learnindya/Bionic-Clicker/WhatsApp Image 2019-11-04 at 14.49.18.jpeg

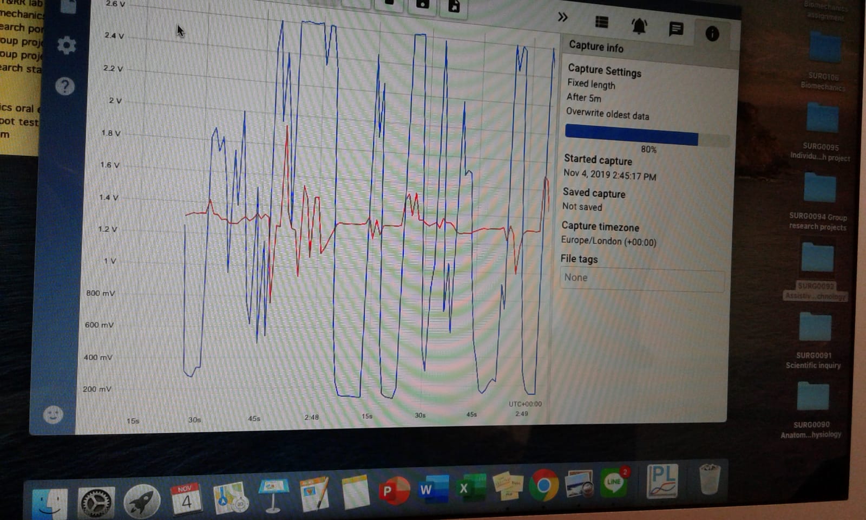
WhatsApp Image 2019-11-04 at 14.49.18.jpeg
