learnindya/Bionic-Clicker/README.md

# Bionic-Clicker
Adaptive Switch Prototype Using Electromyography (EMG) Signal To Access Keyboard Functions
