learnindya/Bionic-Clicker/Bionic clicker raw.png

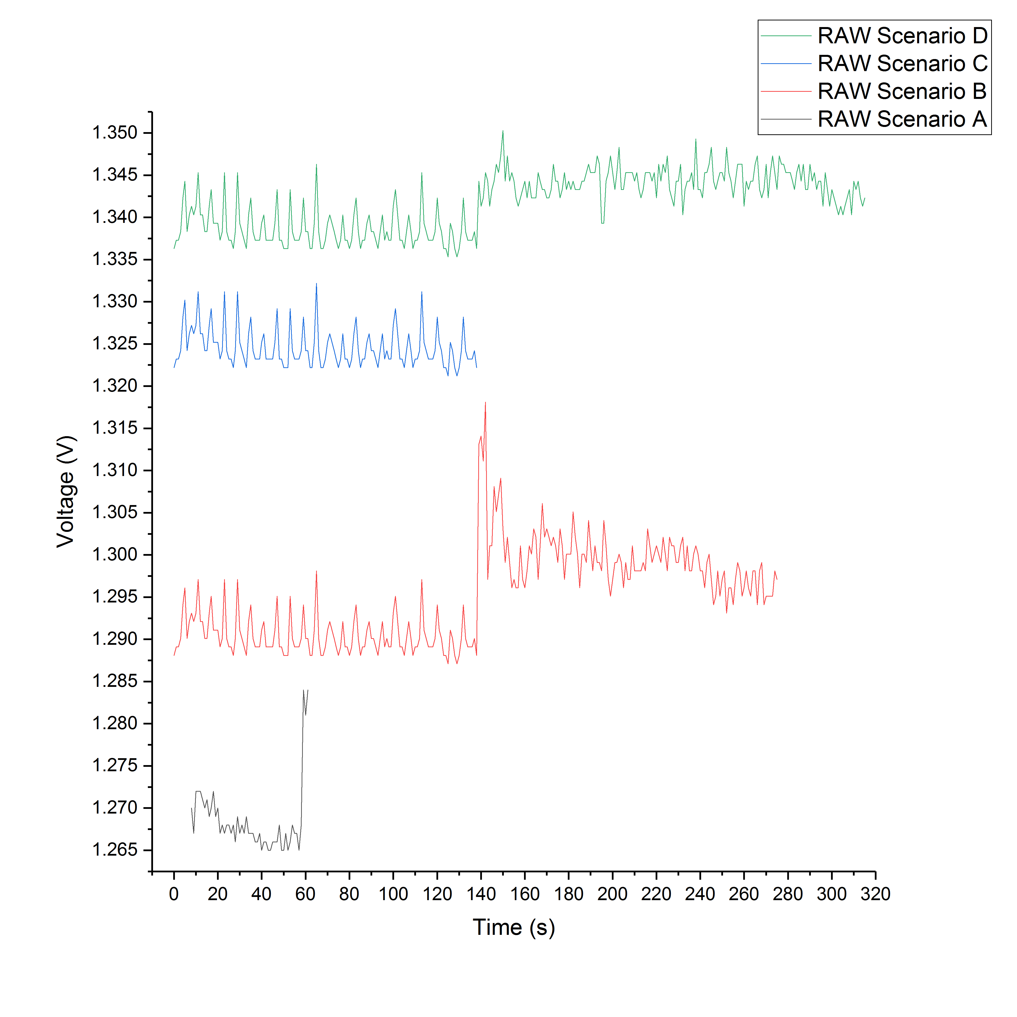
Bionic clicker raw.png
