learnindya/Bionic-Clicker/EMG output 2.jpg

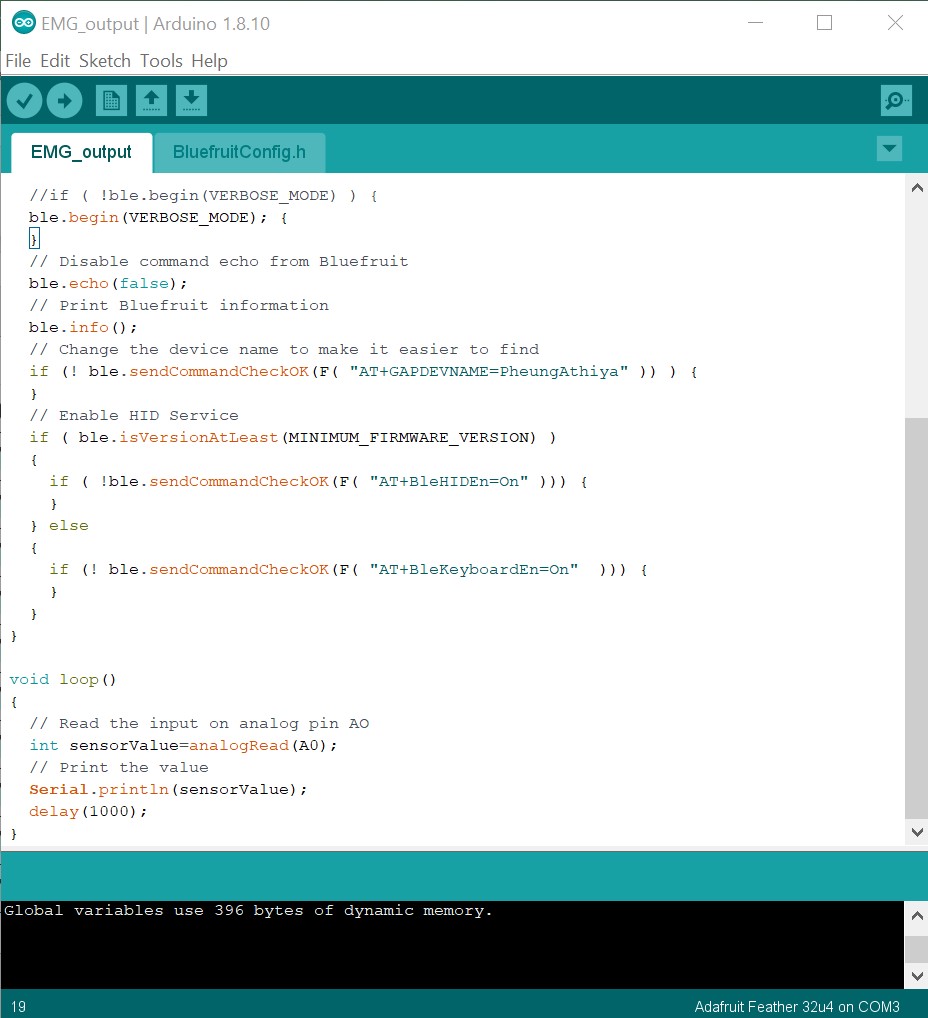
EMG output 2.jpg
