learnindya/Bionic-Clicker/EMG output.jpg

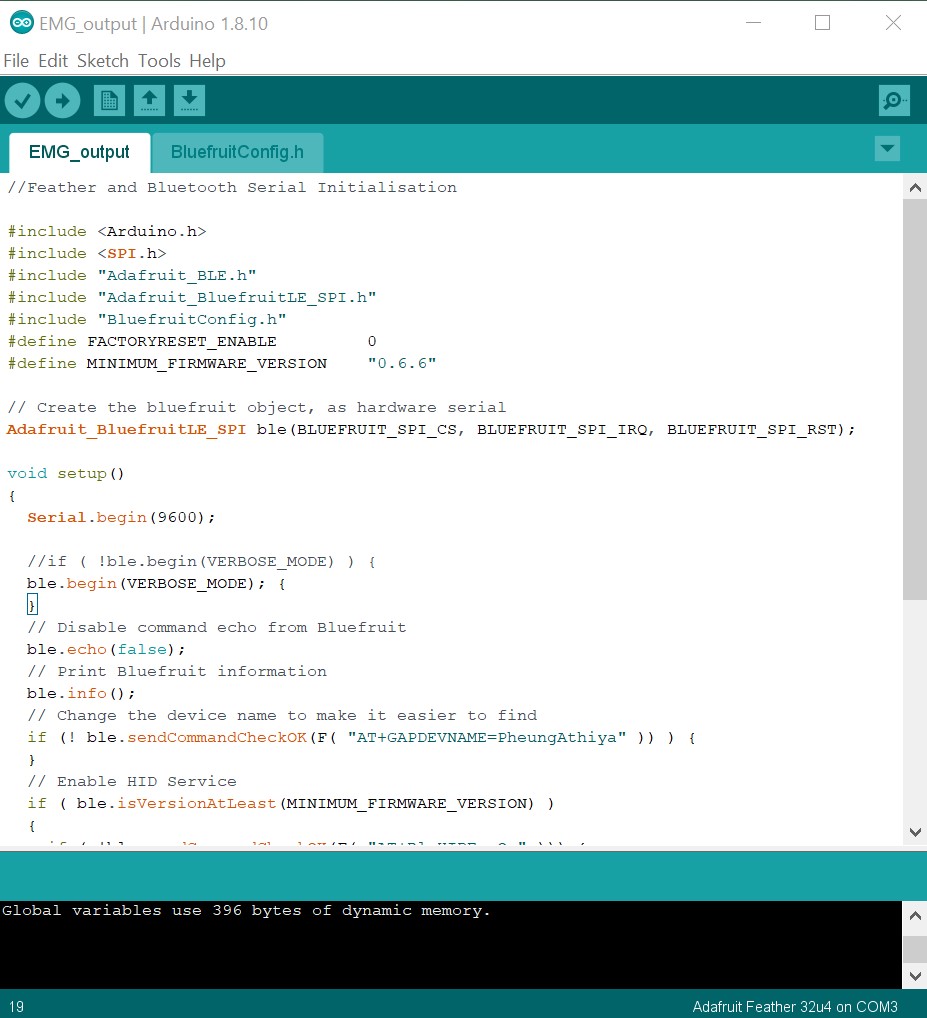
EMG output.jpg
