learnindya/Bionic-Clicker/MyoWare Data Sheet Electrical Specification.jpg

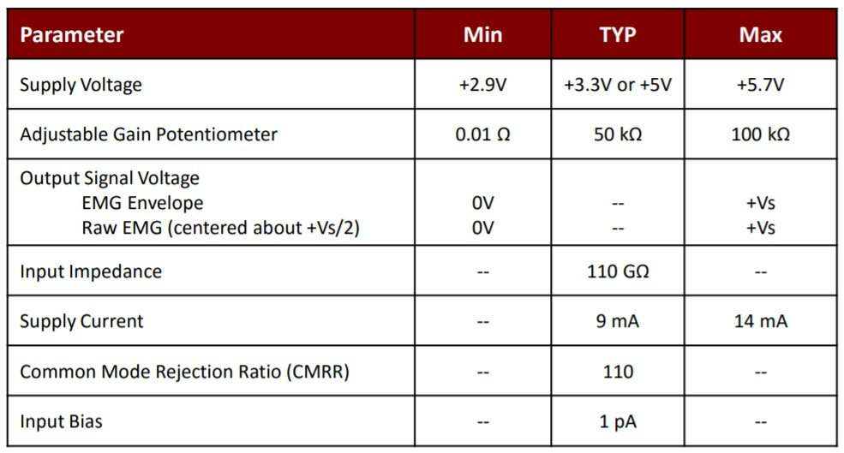
MyoWare Data Sheet Electrical Specification.jpg
