learnindya/Bionic-Clicker/outside forearm.png

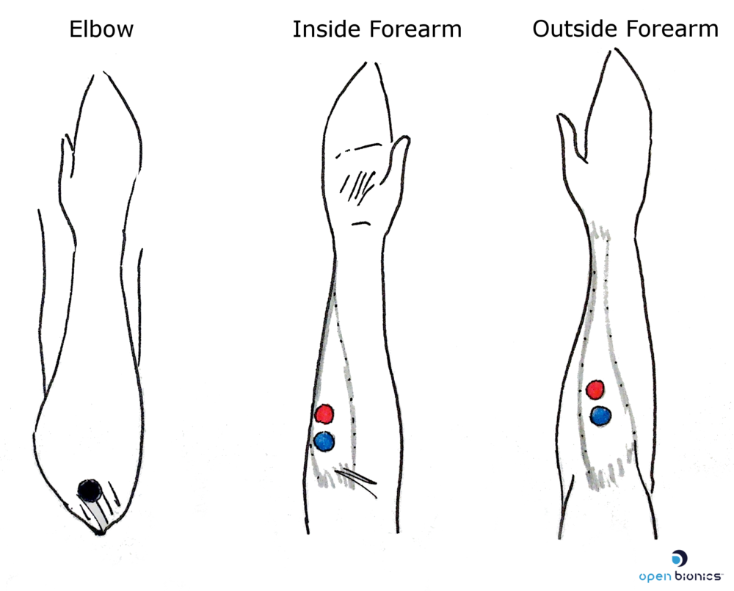
outside forearm.png
