learnindya/Bionic-Clicker/Serial Initialisation 2.jpg

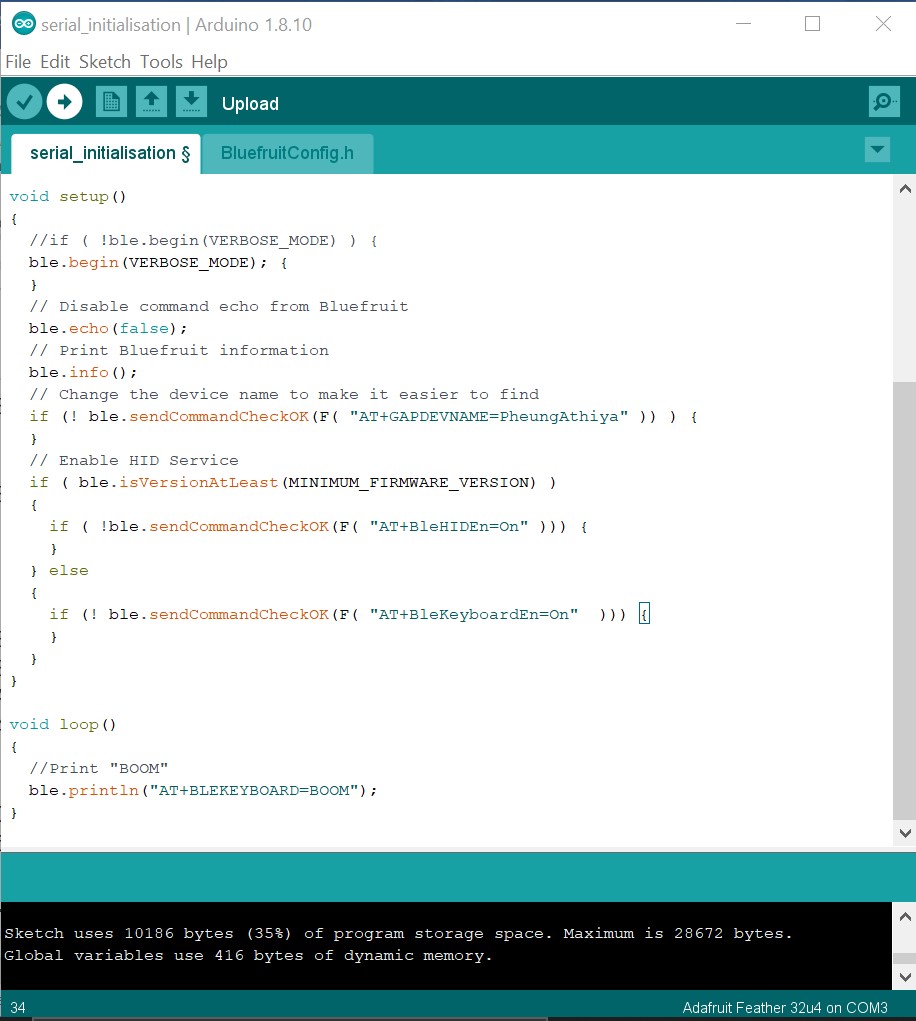
Serial Initialisation 2.jpg
