learnindya/Bionic-Clicker/Serial Initialisation.jpg

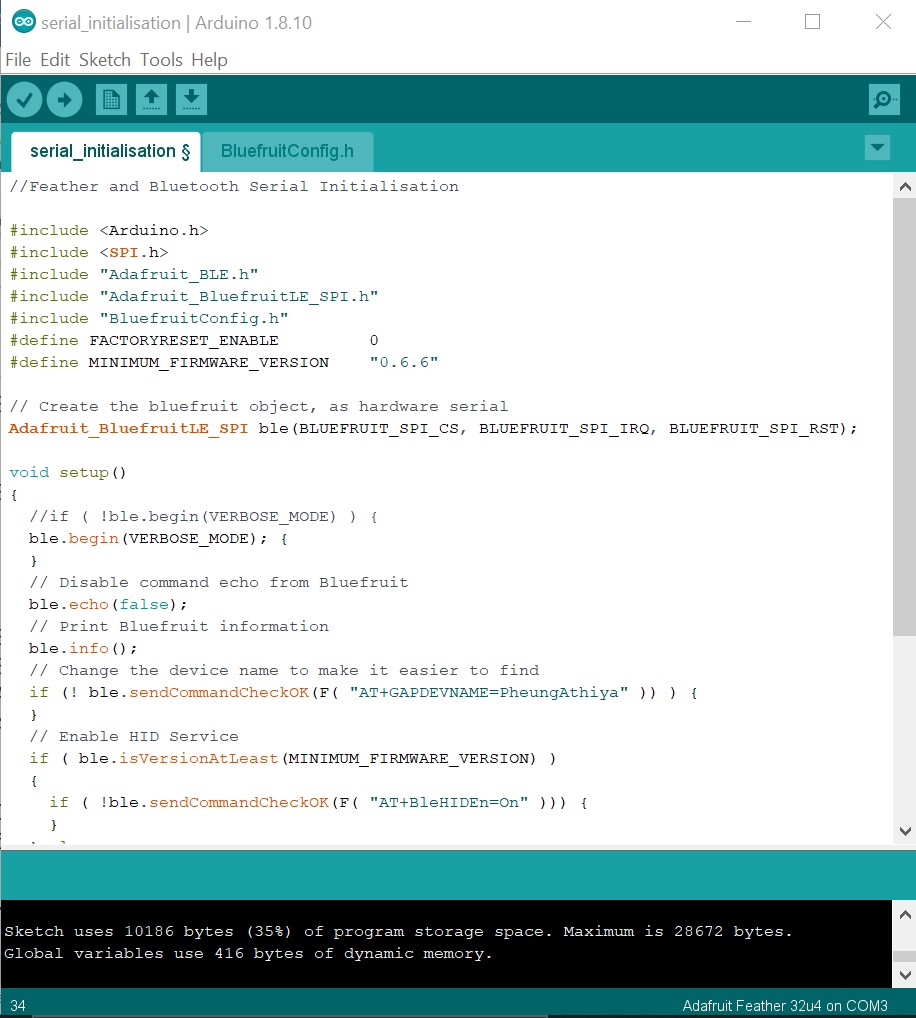
Serial Initialisation.jpg
