learnindya/Bionic-Clicker/WhatsApp Image 2019-11-17 at 11.56.23 (2).jpeg

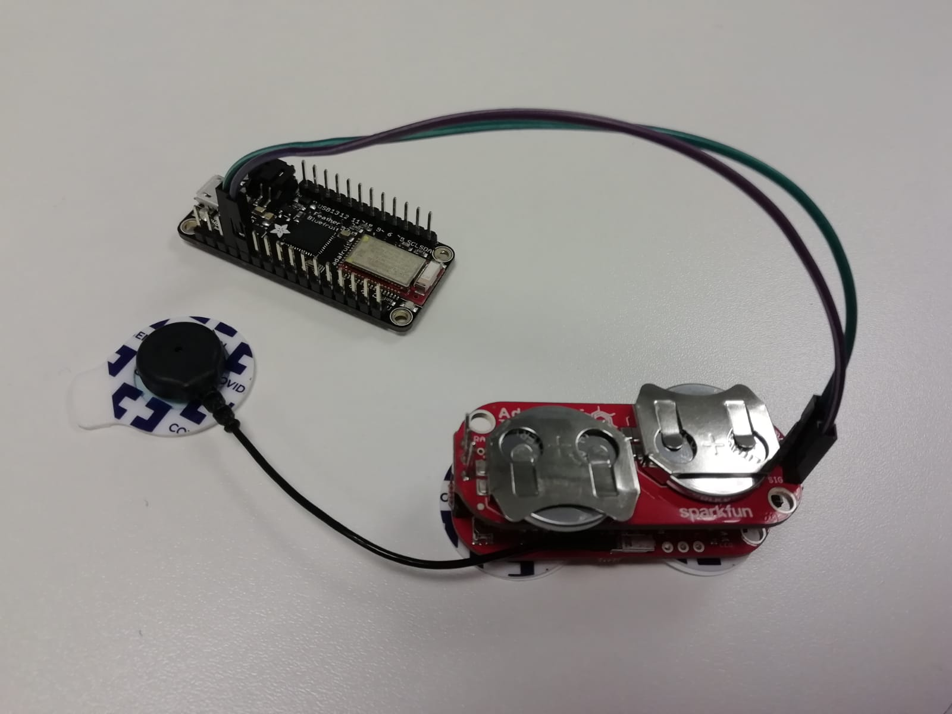
WhatsApp Image 2019-11-17 at 11.56.23 (2).jpeg
