learnindya/Bionic-Clicker/WhatsApp Image 2019-11-17 at 12.03.00.jpeg

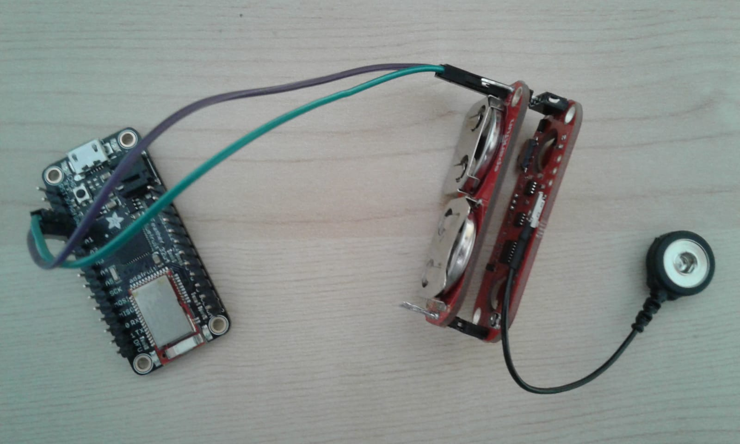
WhatsApp Image 2019-11-17 at 12.03.00.jpeg
