learnindya/Bionic-Clicker/Combined Graph.xlsx

Sheet: A 1-1
 |  |  |  |  | RAW |  |  |  |  |  |  |  |  |  | SIG
 |  | Channel A Last (V) | Channel B Max. (V) |  | rest | rest (avg) |  |  | STD | contract | contract (avg) |  |  | STD | rest | rest (avg) |  |  | STD | contract | contract (avg) |  |  | STD | RAW
 |  |  |  |  |  | 1.268153846 | 1.615135974 | 0.6873045357 | 0.8290383198 |  | 1.268821429 | #REF! | #REF! | #REF! |  | 0.6280769231 | 0.34257609 | 0.2043688857 | 0.4520717706 |  | 1.009892857 | 0.8238866131 | 0.3797114541 | 0.6162073142 | Scenario | Value at Rest (mV) | Value at Contraction (mV)
 |  |  |  |  |  |  | 1.615135974 |  |  |  |  | #REF! |  |  |  |  | 0.34257609 |  |  |  |  | 0.8238866131 |  |  | A
 |  |  |  |  |  |  | 1.615135974 |  |  |  |  | #REF! |  |  |  |  | 0.34257609 |  |  |  |  | 0.8238866131 |  |  | B
 |  |  |  |  |  |  | 1.615135974 |  |  |  |  | #REF! |  |  |  |  | 0.34257609 |  |  |  |  | 0.8238866131 |  |  | C
0:00:08 | 8 | 0.657 | 1.27 | rest | 1.27 |  | 7.744e-07 |  |  |  |  | #REF! |  |  | 0.657 |  | 0.00514089 |  |  |  |  | 0.06284146512 |  |  | D
0:00:09 | 9 | 1.081 | 1.267 | contract |  |  | 1.50544e-05 |  |  | 1.267 |  | #REF! |  |  |  |  | 0.24571849 |  |  | 1.081 |  | 0.03003912912
0:00:10 | 10 | 0.775 | 1.272 | rest | 1.272 |  | 1.2544e-06 |  |  |  |  | #REF! |  |  | 0.775 |  | 0.03598609 |  |  |  |  | 0.01760451312
0:00:11 | 11 | 1.049 | 1.272 | contract |  |  | 1.2544e-06 |  |  | 1.272 |  | #REF! |  |  |  |  | 0.21501769 |  |  | 1.049 |  | 0.01997077712 |  |  | SIG
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
 |  |  |  |  |  |  | 1.615135974 |  |  |  |  | #REF! |  |  |  |  | 0.34257609 |  |  |  |  | 0.8238866131
 |  |  |  |  |  |  | 1.615135974 |  |  |  |  | #REF! |  |  |  |  | 0.34257609 |  |  |  |  | 0.8238866131
 |  |  |  |  |  |  | 1.615135974 |  |  |  |  | #REF! |  |  |  |  | 0.34257609 |  |  |  |  | 0.8238866131
 |  |  |  |  |  |  | 1.615135974 |  |  |  |  | #REF! |  |  |  |  | 0.34257609 |  |  |  |  | 0.8238866131
 |  |  |  |  |  |  | 1.615135974 |  |  |  |  | #REF! |  |  |  |  | 0.34257609 |  |  |  |  | 0.8238866131
 |  |  |  |  |  |  | 1.615135974 |  |  |  |  | #REF! |  |  |  |  | 0.34257609 |  |  |  |  | 0.8238866131
 |  |  |  |  |  |  | 1.615135974 |  |  |  |  | #REF! |  |  |  |  | 0.34257609 |  |  |  |  | 0.8238866131
 |  |  |  |  |  |  | 1.615135974 |  |  |  |  | #REF! |  |  |  |  | 0.34257609 |  |  |  |  | 0.8238866131
 |  |  |  |  |  |  | 1.615135974 |  |  |  |  | #REF! |  |  |  |  | 0.34257609 |  |  |  |  | 0.8238866131
 |  |  |  |  |  |  | 1.615135974 |  |  |  |  | #REF! |  |  |  |  | 0.34257609 |  |  |  |  | 0.8238866131
 |  |  |  |  |  |  | 1.615135974 |  |  |  |  | #REF! |  |  |  |  | 0.34257609 |  |  |  |  | 0.8238866131

Sheet: B 1-5
 |  | Channel A Last (V) | Channel B Max. (V) |  | rest | rest (avg) |  |  | Standard deviation | contract | contract (avg) |  |  | Standard deviation
0:00:00 | 0 | 0.136 | 1.262 | rest | 0.136 | 0.2600944206 | 0.01539932084 | 0.08957443305 | 0.2992898813 |  | 0.9212790698 | 0.6166631078 | 0.3905212854 | 0.6249170228
0:00:01 | 1 | 0.135 | 1.263 | rest | 0.135 |  | 0.01564850884 |  |  |  |  | 0.6182346658
0:00:02 | 2 | 0.135 | 1.263 | rest | 0.135 |  | 0.01564850884 |  |  |  |  | 0.6182346658
0:00:03 | 3 | 0.437 | 1.264 | rest | 0.437 |  | 0.03129573284 |  |  |  |  | 0.2345261498
0:00:04 | 4 | 0.69 | 1.268 | rest | 0.69 |  | 0.1848191688 |  |  |  |  | 0.05348997584
0:00:05 | 5 | 1.064 | 1.27 | contract |  |  | 0.6462648568 |  |  | 1.064 |  | 0.02036928384
0:00:06 | 6 | 0.6 | 1.264 | rest | 0.6 |  | 0.1155360888 |  |  |  |  | 0.1032201958
0:00:07 | 7 | 0.422 | 1.266 | rest | 0.422 |  | 0.02621355284 |  |  |  |  | 0.2492795198
0:00:08 | 8 | 0.42 | 1.267 | rest | 0.42 |  | 0.02556992884 |  |  |  |  | 0.2512806358
0:00:09 | 9 | 0.42 | 1.266 | rest | 0.42 |  | 0.02556992884 |  |  |  |  | 0.2512806358
0:00:10 | 10 | 0.539 | 1.267 | rest | 0.539 |  | 0.07778855684 |  |  |  |  | 0.1461372338
0:00:11 | 11 | 0.958 | 1.271 | contract |  |  | 0.4870727848 |  |  | 0.958 |  | 0.001348431841
0:00:12 | 12 | 0.818 | 1.266 | contract |  |  | 0.3112591048 |  |  | 0.818 |  | 0.01066655184
0:00:13 | 13 | 0.435 | 1.266 | rest | 0.435 |  | 0.03059210884 |  |  |  |  | 0.2364672658
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
0:02:23 | 273 | 0.189 | 1.269 | rest | 0.189 |  | 0.005054356836 |  |  |  |  | 0.5362325338
0:02:24 | 274 | 0.192 | 1.272 | rest | 0.192 |  | 0.004636792836 |  |  |  |  | 0.5318478598
0:02:25 | 275 | 0.158 | 1.271 | rest | 0.158 |  | 0.01042318484 |  |  |  |  | 0.5825948318

Sheet: C 5-1
 |  | Channel A Last (V) | Channel B Max. (V) |  | rest | rest (avg) |  |  | Standard deviation | contract | contract (avg) |  |  | Standard deviation
0:00:00 | 0 | 0.136 | 1.262 | rest | 0.136 | 0.2303461538 | 0.008901167716 | 0.135607856 | 0.3682497196 |  | 0.8819714286 | 0.5564727328 | 0.346387743 | 0.588547146
0:00:01 | 1 | 0.135 | 1.263 | rest | 0.135 |  | 0.009090859716 |  |  |  |  | 0.5579656748
0:00:02 | 2 | 0.135 | 1.263 | rest | 0.135 |  | 0.009090859716 |  |  |  |  | 0.5579656748
0:00:03 | 3 | 0.437 | 1.264 | rest | 0.437 |  | 0.04270587572 |  |  |  |  | 0.1979991908
0:00:04 | 4 | 0.69 | 1.268 | rest | 0.69 |  | 0.2112817997 |  |  |  |  | 0.03685286484
0:00:05 | 5 | 1.064 | 1.27 | contract |  |  | 0.6949789917 |  |  | 1.064 |  | 0.03313455684
0:00:06 | 6 | 0.6 | 1.264 | contract |  |  | 0.1366440797 |  |  | 0.6 |  | 0.07950764484
0:00:07 | 7 | 0.422 | 1.266 | rest | 0.422 |  | 0.03673125572 |  |  |  |  | 0.2115733208
0:00:08 | 8 | 0.42 | 1.267 | rest | 0.42 |  | 0.03596863972 |  |  |  |  | 0.2134172048
0:00:09 | 9 | 0.42 | 1.266 | rest | 0.42 |  | 0.03596863972 |  |  |  |  | 0.2134172048
0:00:10 | 10 | 0.539 | 1.267 | rest | 0.539 |  | 0.09526729172 |  |  |  |  | 0.1176291068
0:00:11 | 11 | 0.958 | 1.271 | contract |  |  | 0.5294803437 |  |  | 0.958 |  | 0.005780408841
0:00:12 | 12 | 0.818 | 1.266 | contract |  |  | 0.3453372237 |  |  | 0.818 |  | 0.004092288841
0:00:13 | 13 | 0.435 | 1.266 | rest | 0.435 |  | 0.04188325972 |  |  |  |  | 0.1997830748
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
0:02:16 | 136 | 0.138 | 1.263 | rest | 0.138 |  | 0.008527783716 |  |  |  |  | 0.5534928488
0:02:17 | 137 | 0.136 | 1.264 | rest | 0.136 |  | 0.008901167716 |  |  |  |  | 0.5564727328
0:02:18 | 138 | 0.172 | 1.262 | rest | 0.172 |  | 0.003404255716 |  |  |  |  | 0.5040588208

Sheet: D 5-5
 |  | Channel A Max. (V) | Channel B Max. (V) |  | rest | rest (avg) |  |  | Standard deviation | contract | contract (avg) |  |  | Standard deviation
0:00:00 | 0 | 0.136 | 1.262 | rest | 0.136 | 0.2709065934 | 0.01819989865 | 0.08471322291 | 0.2910553606 |  | 0.6388731343 | 0.2528812541 | 0.1052802866 | 0.3244692383
0:00:01 | 1 | 0.135 | 1.263 | rest | 0.135 |  | 0.01847071265 |  |  |  |  | 0.2538880001
0:00:02 | 2 | 0.135 | 1.263 | rest | 0.135 |  | 0.01847071265 |  |  |  |  | 0.2538880001
0:00:03 | 3 | 0.437 | 1.264 | rest | 0.437 |  | 0.02758688465 |  |  |  |  | 0.04075270813
0:00:04 | 4 | 0.69 | 1.268 | contract |  |  | 0.1756389426 |  |  | 0.69 |  | 0.002613970129
0:00:05 | 5 | 1.064 | 1.27 | contract |  |  | 0.6289965066 |  |  | 1.064 |  | 0.1807329661
0:00:06 | 6 | 0.6 | 1.264 | contract |  |  | 0.1083022026 |  |  | 0.6 |  | 0.001511110129
0:00:07 | 7 | 0.422 | 1.266 | rest | 0.422 |  | 0.02282909465 |  |  |  |  | 0.04703389813
0:00:08 | 8 | 0.42 | 1.267 | rest | 0.42 |  | 0.02222872265 |  |  |  |  | 0.04790539013
0:00:09 | 9 | 0.42 | 1.266 | rest | 0.42 |  | 0.02222872265 |  |  |  |  | 0.04790539013
0:00:10 | 10 | 0.539 | 1.267 | contract |  |  | 0.07187385665 |  |  | 0.539 |  | 0.009974616129
0:00:11 | 11 | 0.958 | 1.271 | contract |  |  | 0.4720967906 |  |  | 0.958 |  | 0.1018420421
0:00:12 | 12 | 0.818 | 1.266 | contract |  |  | 0.2993107506 |  |  | 0.818 |  | 0.03208648213
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
0:02:53 | 312 | 0.173 | 1.27 | rest | 0.173 |  | 0.009585780649 |  |  |  |  | 0.2170376521
0:02:54 | 313 | 0.186 | 1.268 | rest | 0.186 |  | 0.007209198649 |  |  |  |  | 0.2050939541
0:02:55 | 314 | 0.142 | 1.267 | rest | 0.142 |  | 0.01661701465 |  |  |  |  | 0.2468827781
0:02:56 | 315 | 0.162 | 1.268 | rest | 0.162 |  | 0.01186073465 |  |  |  |  | 0.2274078581
