learnindya/Bionic-Clicker/Experiment.xlsx

Sheet: Sheet1
THRESHOLD = 200 |  |  |  |  |  |  |  | THRESHOLD = 240 |  |  |  |  |  |  |  | THRESHOLD = 200 |  |  |  | THRESHOLD = 200 | THRESHOLD = 200 | THRESHOLD = 200 | THRESHOLD = 200 | THRESHOLD = 200
ATHIYA | 1:SHORT | 2:LONG | 3:MOVE | 4:NO MOVE | SHORT/LONG/MOVE |  |  | ATHIYA | 1:SHORT | 2:LONG | 3:MOVE | 4:NO MOVE | SHORT/LONG/MOVE |  |  | n=110 | Predicted: NO | Predicted: YES | TRUE POSITIVE
1 | SHORT | LONG |  |  | SHORT | LONG | SHORT | 1 | SHORT | SHORT |  |  | SHORT |  |  | Actual: NO | 45 | 17 | FALSE NEGATIVE
2 | SHORT | SHORT |  |  | SHORT | LONG |  | 2 | SHORT | SHORT | SHORT |  | LONG | LONG | SHORT | Actual: YES |  | 48 | FALSE POSITIVE
3 | SHORT | LONG |  |  | SHORT | LONG | SHORT | 3 | SHORT | SHORT |  |  | SHORT | LONG | SHORT |  |  |  | TRUE NEGATIVE
4 | SHORT | SHORT |  |  | SHORT | LONG |  | 4 | SHORT | SHORT | LONG |  | SHORT | SHORT
5 | SHORT | SHORT |  |  | SHORT | LONG | SHORT | 5 | SHORT | SHORT |  |  | LONG | LONG |  | THRESHOLD = 240
6 | SHORT | SHORT |  |  | SHORT | LONG | LONG | 6 | SHORT | SHORT |  |  | SHORT | LONG |  | n=110 | Predicted: NO | Predicted: YES
7 | SHORT | SHORT |  |  | SHORT | LONG |  | 7 |  | LONG |  |  | SHORT | LONG | SHORT | Actual: NO | 44 | 18
8 | SHORT | LONG |  |  | SHORT | LONG | SHORT | 8 | SHORT | LONG |  |  | SHORT | SHORT |  | Actual: YES | 9 | 39
9 | SHORT | SHORT |  |  | SHORT | LONG |  | 9 | SHORT | SHORT |  |  | SHORT | LONG
10 | SHORT | LONG |  |  | SHORT | SHORT |  | 10 |  | LONG |  |  | SHORT | LONG | SHORT
11 | SHORT | SHORT |  |  |  |  |  | 11 |  | LONG |  |  |  |  |  | THRESHOLD = 160
12 | SHORT | LONG |  |  |  |  |  | 12 |  | SHORT |  |  |  |  |  | n=110 | Predicted: NO | Predicted: YES
13 | SHORT | LONG |  |  |  |  |  | 13 |  | LONG |  |  |  |  |  | Actual: NO | 42 | 17
14 | SHORT | LONG |  |  |  |  |  | 14 | SHORT | LONG |  |  |  |  |  | Actual: YES |  | 51
15 | SHORT | SHORT |  |  |  |  |  | 15 | SHORT | LONG
16 | SHORT | SHORT |  |  |  |  |  | 16 | SHORT | LONG |  |  |  |  |  | Threshold | Accuracy | Precision | TRUE POSITIVE
17 | SHORT | SHORT |  |  |  |  |  | 17 | SHORT | LONG |  |  |  |  |  | 160 | 0.8454545455 | 0.75 | FALSE NEGATIVE
18 | SHORT | SHORT |  |  |  |  |  | 18 |  | LONG |  |  |  |  |  | 200 | 0.8454545455 | 0.7384615385 | FALSE POSITIVE
19 | SHORT | LONG |  |  |  |  |  | 19 |  | LONG |  |  |  |  |  | 240 | 0.7545454545 | 0.6842105263 | TRUE NEGATIVE
20 | SHORT | LONG |  |  |  |  |  | 20 |  | LONG
 |  | SHORT= FALSE POSITIVE
 |  |  |  |  |  |  |  |  | SHORT = TRUE POSITIVE
 |  |  |  |  |  |  |  |  | NO = FALSE NEGATIVE
 |  |  |  |  |  |  |  |  | LONG = FALSE POSITIVE

Sheet: Sheet2
THRESHOLD = 200 |  |  |  |  |  |  |  | THRESHOLD = 160
PHEUNG | 1:SHORT | 2:LONG | 3:MOVE | 4:NO MOVE | SHORT/LONG/MOVE |  |  | PHEUNG | 1:SHORT | 2:LONG | 3:MOVE | 4:NO MOVE | SHORT/LONG/MOVE
1 | SHORT | LONG |  |  | LONG | LONG | SHORT | 1 | SHORT | LONG |  |  | SHORT | LONG | LONG
2 | SHORT | SHORT |  |  | LONG | LONG |  | 2 | SHORT | LONG |  |  | SHORT | LONG
3 | SHORT | SHORT |  |  | LONG | LONG |  | 3 | SHORT | LONG |  |  | LONG | LONG
4 | SHORT | LONG |  |  | SHORT | LONG |  | 4 | SHORT | LONG |  |  | LONG | LONG
5 | LONG | LONG |  |  | SHORT | LONG |  | 5 | SHORT | LONG |  |  | LONG | LONG | SHORT
6 | LONG | LONG |  |  | SHORT | LONG |  | 6 | SHORT | LONG |  |  | LONG | LONG
7 | SHORT | LONG |  |  | LONG | LONG |  | 7 | SHORT | LONG |  |  | SHORT | LONG
8 | SHORT | LONG |  |  | SHORT | LONG |  | 8 | SHORT | LONG |  |  | LONG | LONG
9 | SHORT | LONG |  |  | SHORT | LONG |  | 9 | SHORT | SHORT |  |  | LONG | LONG | LONG
10 | SHORT | LONG | SHORT |  | LONG | LONG |  | 10 | SHORT | LONG | LONG |  | LONG | LONG
11 | SHORT | LONG |  |  |  |  |  | 11 | SHORT | LONG | LONG
12 | SHORT | LONG |  |  |  |  |  | 12 | SHORT | LONG | LONG
13 | SHORT | LONG | SHORT |  |  |  |  | 13 | SHORT | LONG | SHORT
14 | SHORT | SHORT | SHORT |  |  |  |  | 14 | SHORT | LONG
15 | SHORT | LONG |  |  |  |  |  | 15 | SHORT | LONG | LONG
16 | SHORT | LONG | LONG |  |  |  |  | 16 | SHORT | LONG
17 | SHORT | SHORT | SHORT |  |  |  |  | 17 | SHORT | LONG
18 | SHORT | SHORT |  |  |  |  |  | 18 | SHORT | LONG
19 | SHORT | SHORT |  |  |  |  |  | 19 | SHORT | LONG
20 | LONG | SHORT |  |  |  |  |  | 20 | LONG | LONG
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
