learnindya/Bionic-Clicker/(list of files, drawings)

Other design files:
bionic clicker.opj
